barn53/barn53-kicad-library/projects/jlcpcb/readme.md

# JLCPCB KiCAD project

This is to store presets especially for PCBNew to match JLCPCB requirements.
