barn53/barn53-kicad-library/3dmodels/JUSHUO_AFC07-S40FCC-00.obj

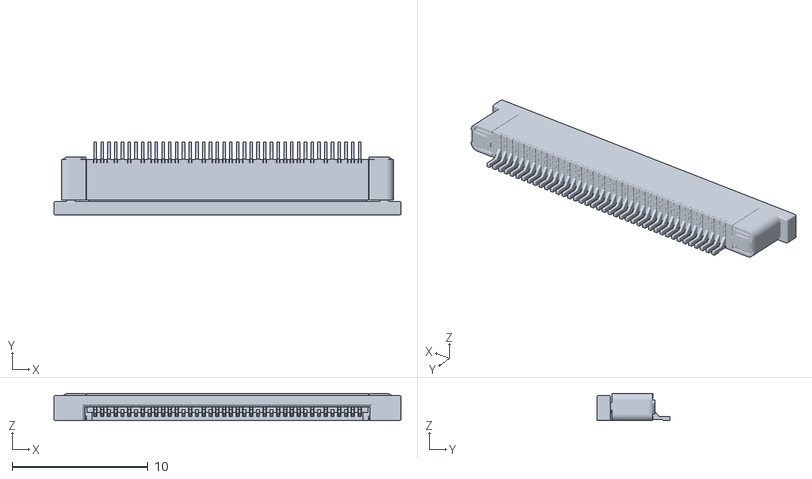
[picture p1: CAD file, 2022-10-30]
3dmodels/JUSHUO_AFC07-S40FCC-00.obj
25.6 x 5.40 x 2.00
