barn53/barn53-kicad-library/3dmodels/JUSHUO_AFC07-S40ECC-00.obj

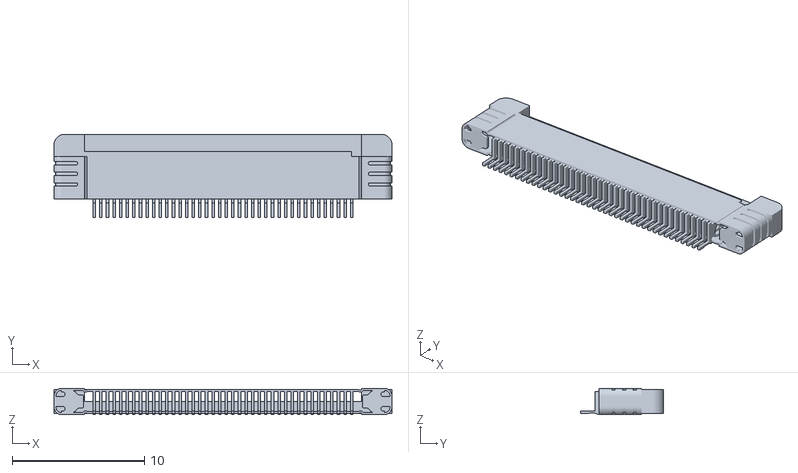
[picture p2: CAD file, 2022-10-30]
3dmodels/JUSHUO_AFC07-S40ECC-00.obj
25.6 x 6.32 x 2.00
