barn53/barn53-kicad-library/3dmodels/JUSHUO_AFC11-S40ICC-00.obj

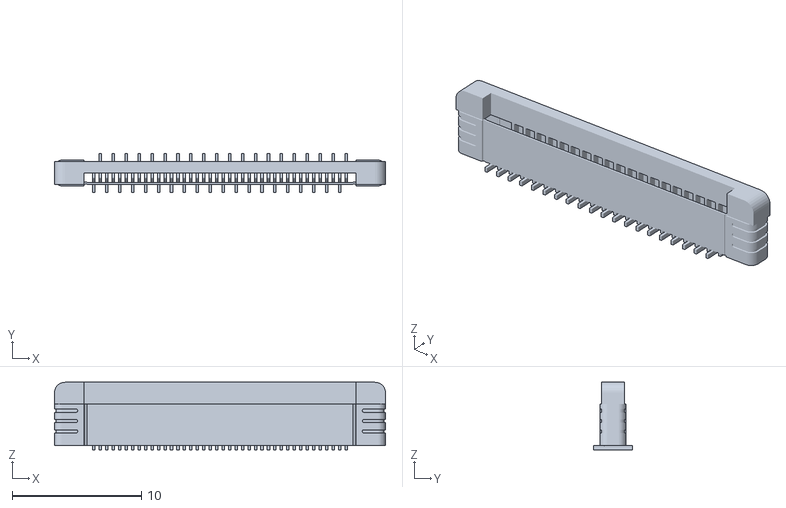
[picture p3: CAD file, 2022-10-30]
3dmodels/JUSHUO_AFC11-S40ICC-00.obj
25.6 x 3.00 x 5.22
