barn53/barn53-kicad-library/3dmodels/IPS_Display_240x320_FPC_105deg.step

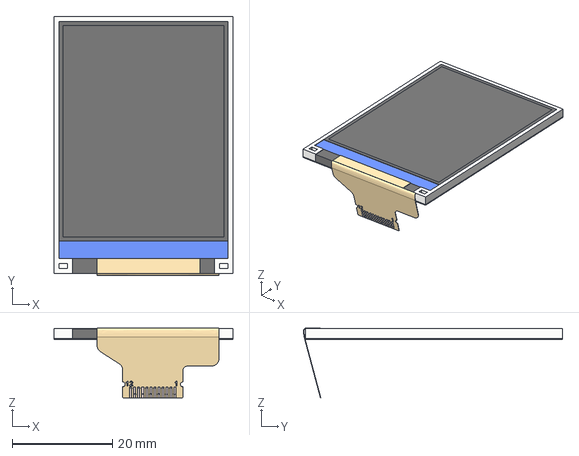
[picture p4: CAD file, 2021-10-30]
3dmodels/IPS_Display_240x320_FPC_105deg.step
35.7 x 51.7 x 14.0 mm
Display
FPC 105
