barn53/barn53-kicad-library/3dmodels/nch8200hv_v2.1.0.1.step

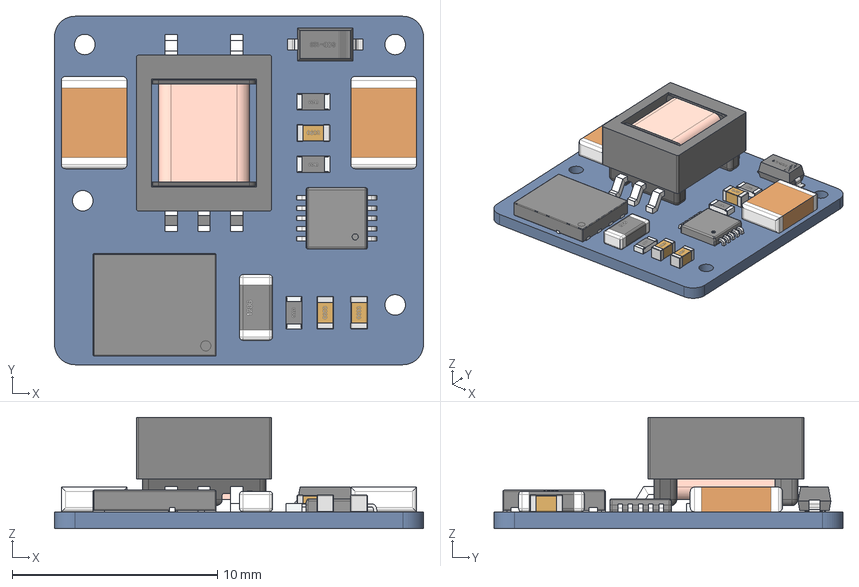
[picture p5: CAD file, 2021-10-26]
3dmodels/nch8200hv_v2.1.0.1.step
18.0 x 17.0 x 5.42 mm
Board
SW3dPS-uMAX10_Part_141
SW3dPS-uMAX10_Part_2291
SW3dPS-uMAX10_Part_1911
SW3dPS-uMAX10_Part_1987
SW3dPS-uMAX10_Part_1492
SW3dPS-uMAX10_Part_2139
SW3dPS-uMAX10_Part_2443
SW3dPS-uMAX10_Part_1799
SW3dPS-uMAX10_Part_2367
SW3dPS-uMAX10_Part_2215
SW3dPS-uMAX10_Part_2063
TTRN-060S
R_0603 x 3
LOGO? x 6
1206R2
User_Library-SON8-5x6mm
SOD-123
LOGOﾔｲ｣ｭ｣ｰ.｣ｳ
1812C x 2
C_0603 x 3
