barn53/barn53-kicad-library/3dmodels/NIXIE Tube Z5900M.step

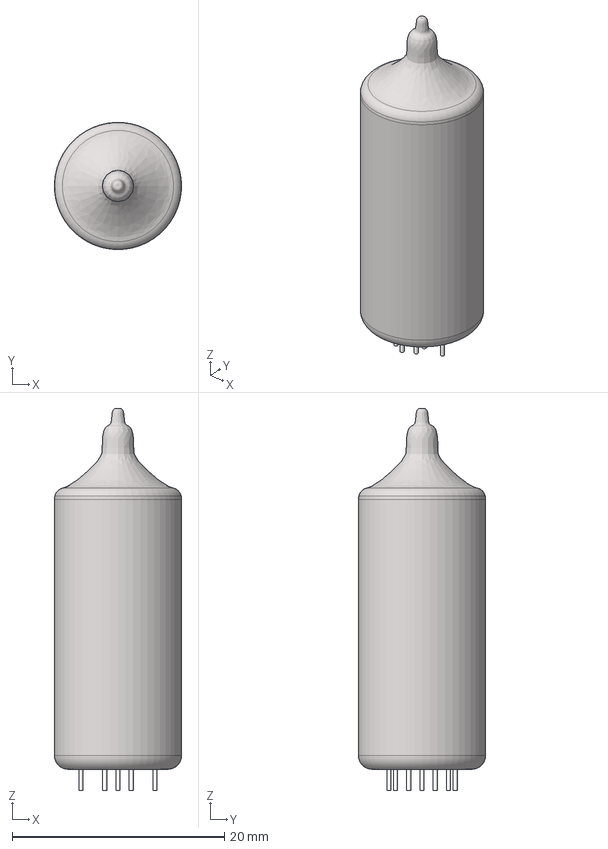
[picture p6: CAD file, 2021-10-26]
3dmodels/NIXIE Tube Z5900M.step
12.0 x 12.0 x 36.0 mm
