barn53/barn53-kicad-library/3dmodels/IPS_Display_240x320_FPC_180deg.step

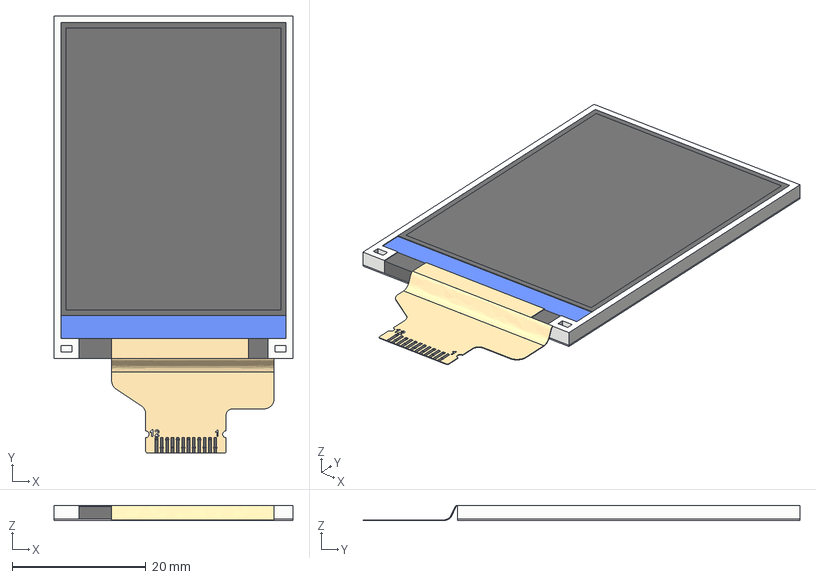
[picture p7: CAD file, 2021-10-25]
3dmodels/IPS_Display_240x320_FPC_180deg.step
35.7 x 65.3 x 2.30 mm
Display
FPC straight
