barn53/barn53-kicad-library/3dmodels/IPS_Display_240x320_FPC_360deg.step

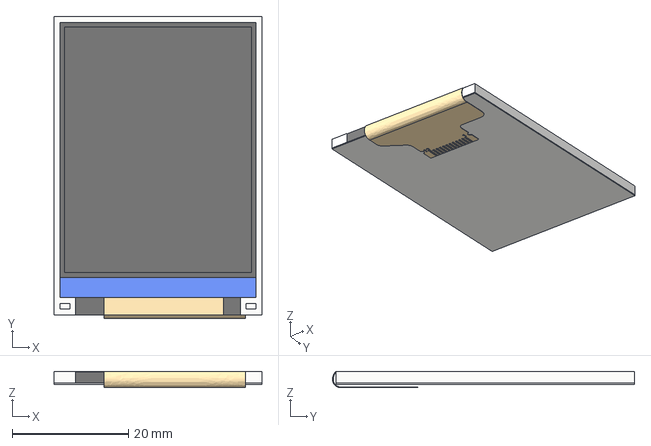
[picture p8: CAD file, 2021-10-25]
3dmodels/IPS_Display_240x320_FPC_360deg.step
35.7 x 51.9 x 2.82 mm
Display
FPC below
