barn53/barn53-kicad-library/3dmodels/NIXIE Tube IN12-B.step

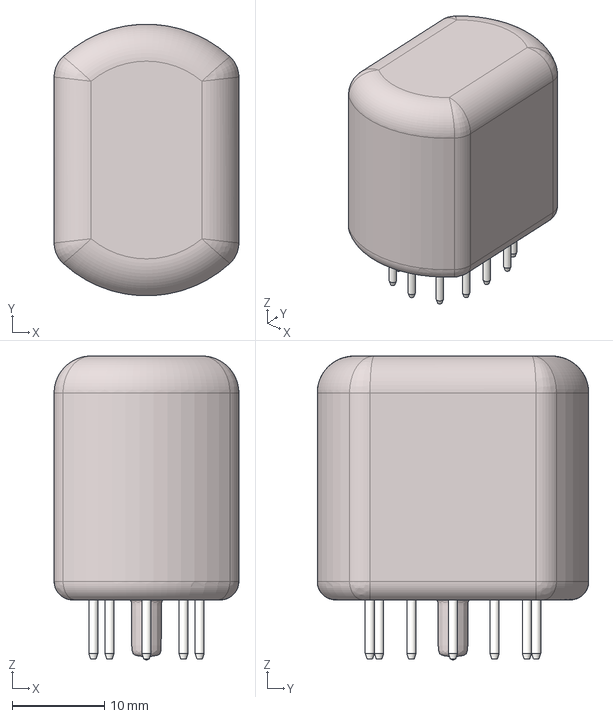
[picture p9: CAD file, 2021-07-06]
3dmodels/NIXIE Tube IN12-B.step
20.0 x 29.4 x 32.9 mm
