barn53/barn53-kicad-library/3dmodels/ePaper_4,2_inch_FPC_180deg.step

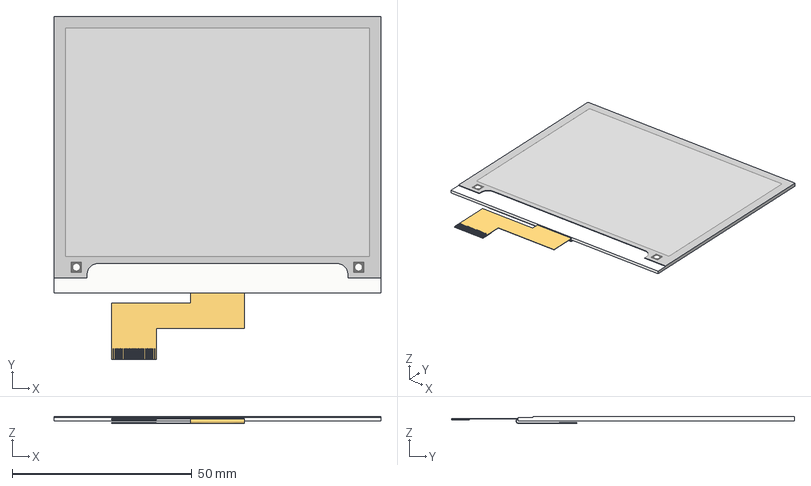
[picture p10: CAD file, 2021-05-12]
3dmodels/ePaper_4,2_inch_FPC_180deg.step
91.0 x 95.5 x 1.87 mm
