barn53/barn53-kicad-library/3dmodels/FPC 24 - AFC07-S24ECA-00.step

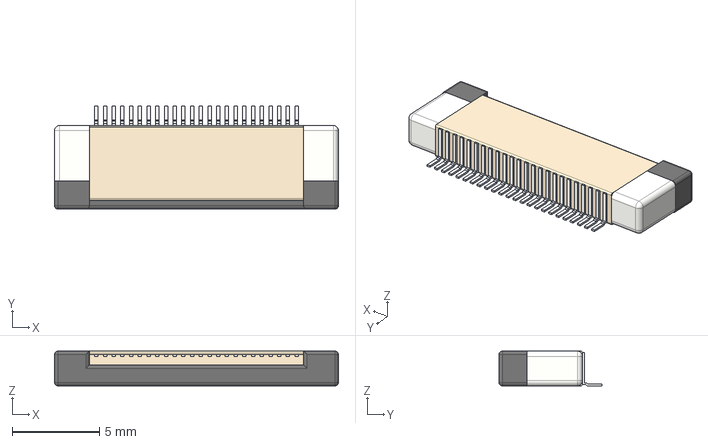
[picture p11: CAD file, 2021-04-11]
3dmodels/FPC 24 - AFC07-S24ECA-00.step
16.3 x 5.92 x 2.00 mm
