barn53/barn53-kicad-library/3dmodels/IPS_Display_240x240_FPC_80deg.step

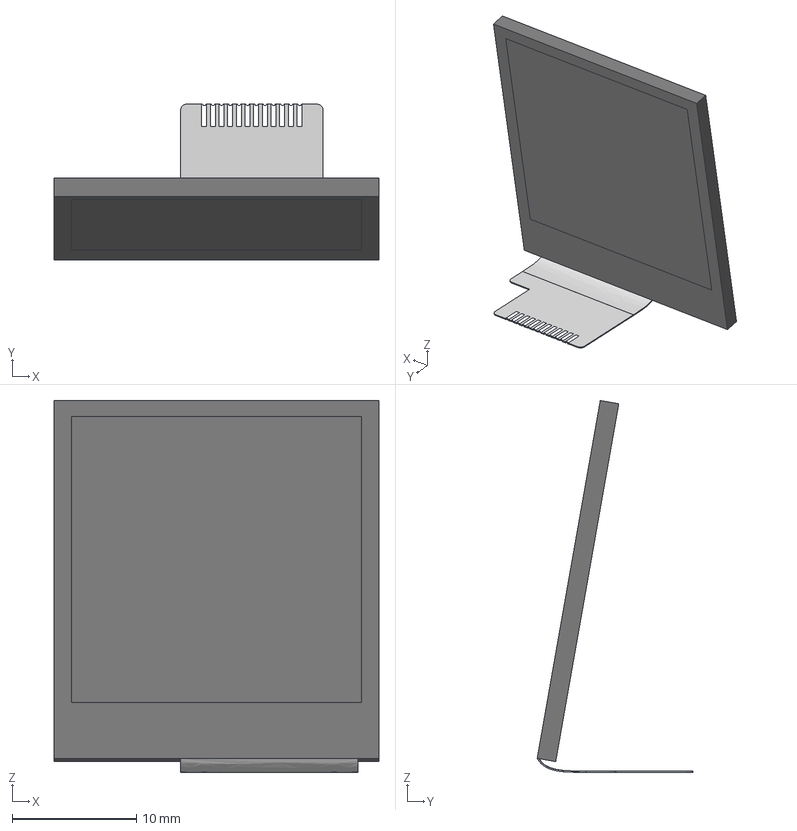
[picture p12: CAD file, 2021-01-22]
3dmodels/IPS_Display_240x240_FPC_80deg.step
26.2 x 12.6 x 30.0 mm
