barn53/barn53-kicad-library/3dmodels/WS2812B-2020.step

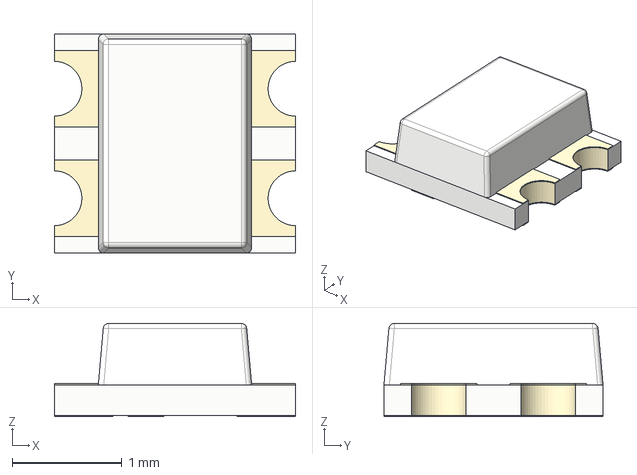
[picture p13: CAD file, 2021-01-22]
3dmodels/WS2812B-2020.step
2.20 x 2.00 x 0.85 mm
