barn53/barn53-kicad-library/3dmodels/IPS_Display_240x240_FPC_15deg.step

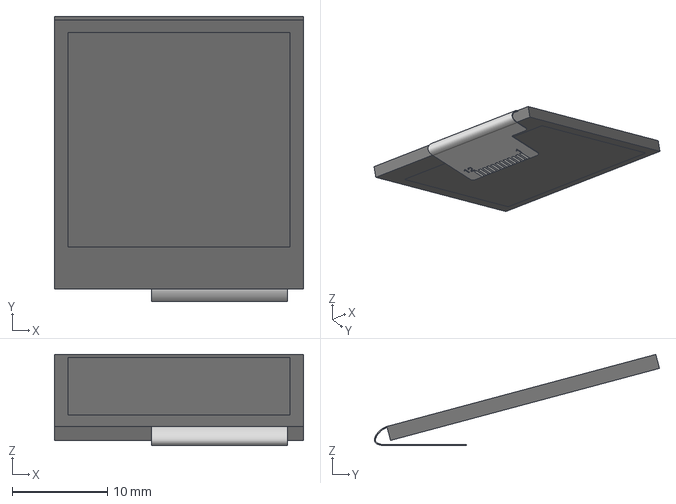
[picture p14: CAD file, 2021-01-07]
3dmodels/IPS_Display_240x240_FPC_15deg.step
26.2 x 30.0 x 9.59 mm
