barn53/barn53-kicad-library/3dmodels/IPS Display 80x160 bottom.step

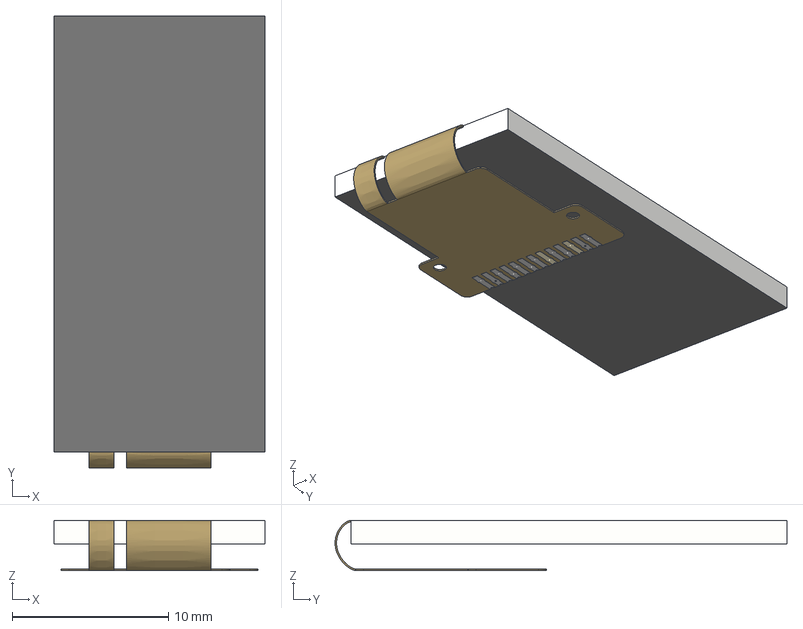
[picture p15: CAD file, 2021-01-07]
3dmodels/IPS Display 80x160 bottom.step
13.5 x 28.9 x 3.21 mm
