barn53/barn53-kicad-library/3dmodels/IPS Display 80x160 top.step

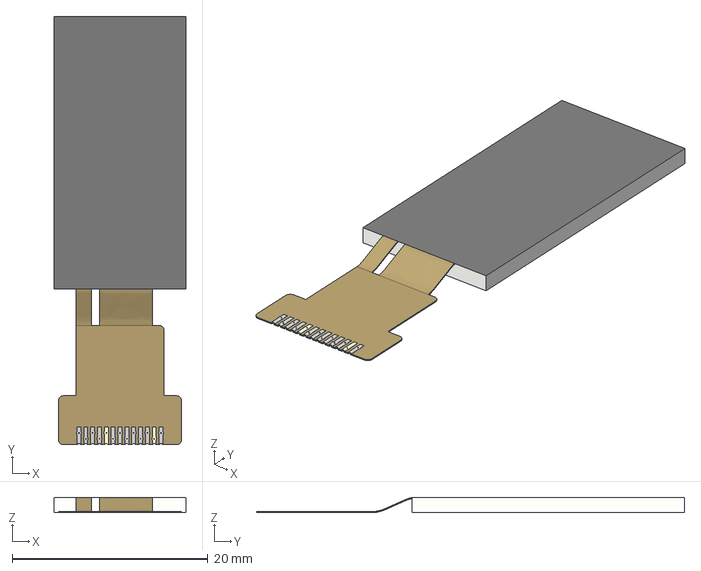
[picture p16: CAD file, 2021-01-07]
3dmodels/IPS Display 80x160 top.step
13.5 x 43.8 x 1.50 mm
