barn53/barn53-kicad-library/3dmodels/SMD Push Button vertical.step

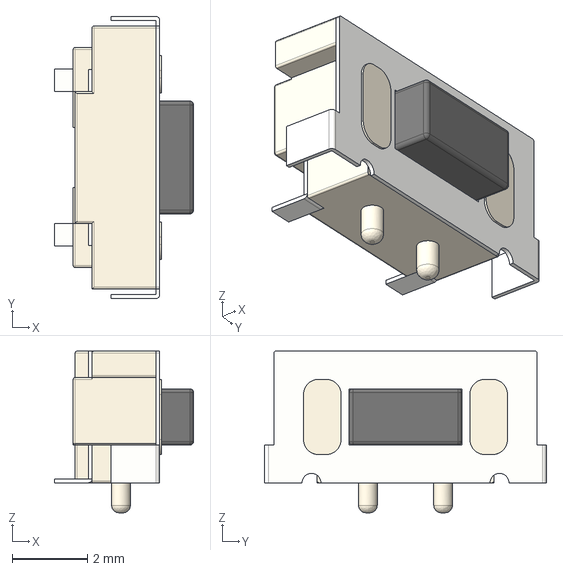
[picture p17: CAD file, 2020-10-26]
3dmodels/SMD Push Button vertical.step
3.70 x 7.50 x 4.30 mm
