barn53/barn53-kicad-library/3dmodels/PogoPin 50x650mil.step

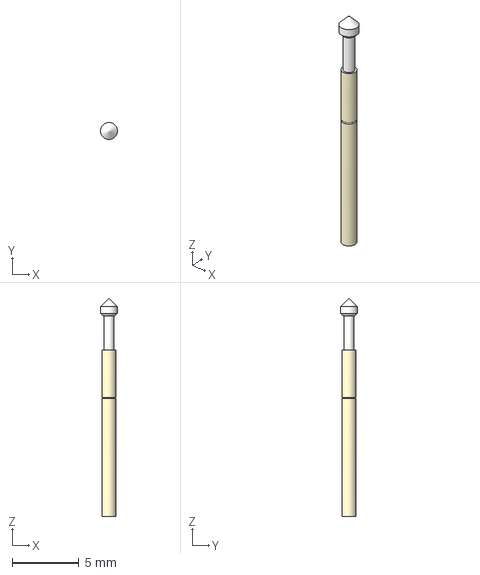
[picture p18: CAD file, 2020-10-06]
3dmodels/PogoPin 50x650mil.step
1.27 x 1.27 x 16.4 mm
