barn53/barn53-kicad-library/3dmodels/SMD Push Button v8.step

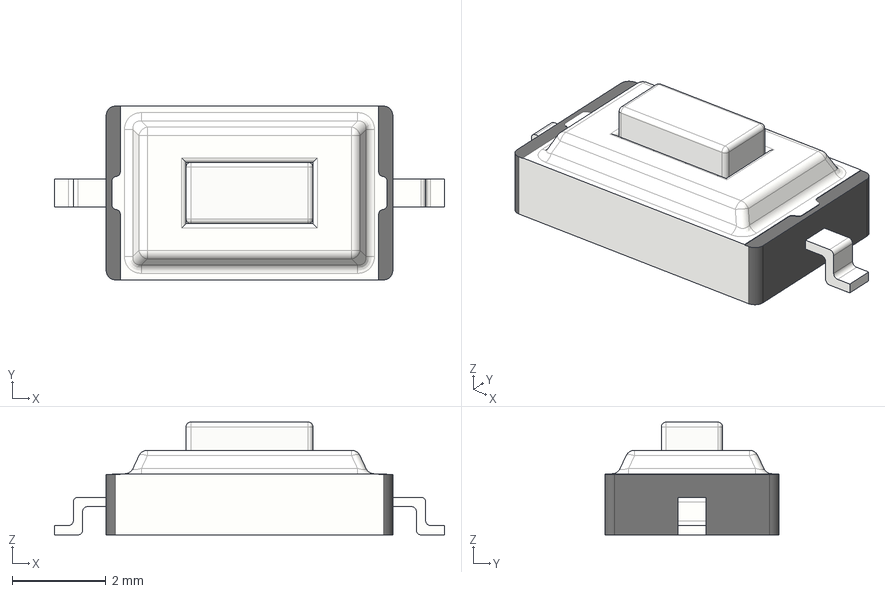
[picture p19: CAD file, 2020-01-07]
3dmodels/SMD Push Button v8.step
8.30 x 3.70 x 2.40 mm
