barn53/barn53-kicad-library/3dmodels/ADXL345_LGA-14_3x5mm.step

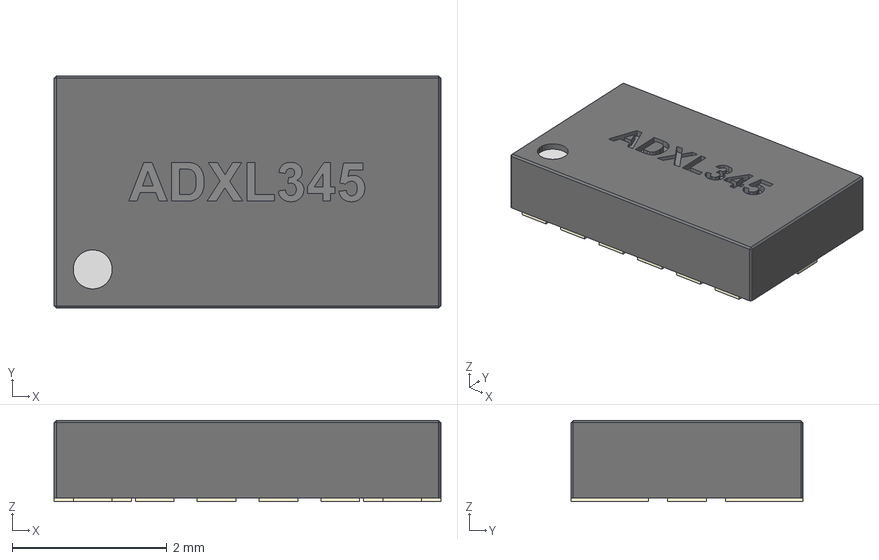
[picture p20: CAD file, 2019-11-14]
3dmodels/ADXL345_LGA-14_3x5mm.step
5.00 x 3.00 x 1.05 mm
