barn53/barn53-kicad-library/3dmodels/PowerPAK SC70-6L.step

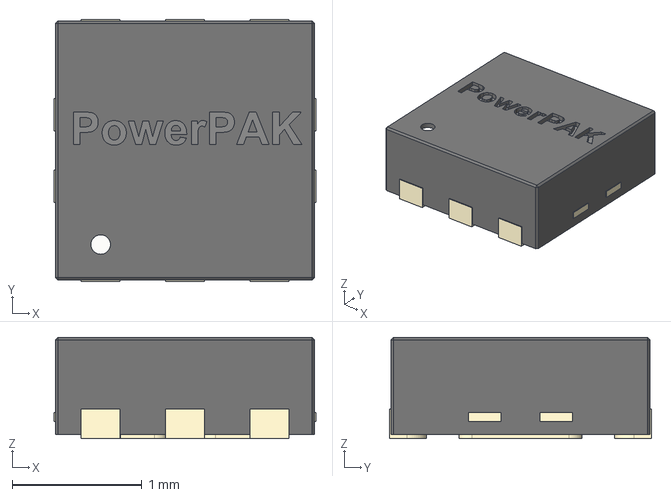
[picture p21: CAD file, 2019-11-14]
3dmodels/PowerPAK SC70-6L.step
2.02 x 2.02 x 0.78 mm
