barn53/barn53-kicad-library/3dmodels/WS2812D-F8.step

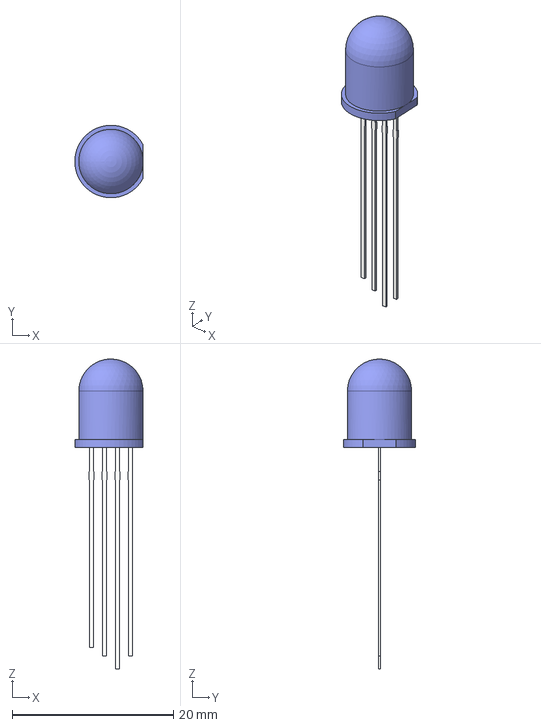
[picture p22: CAD file, 2019-11-13]
3dmodels/WS2812D-F8.step
8.49 x 9.00 x 38.5 mm
