barn53/barn53-kicad-library/3dmodels/WS2812D-F5.step

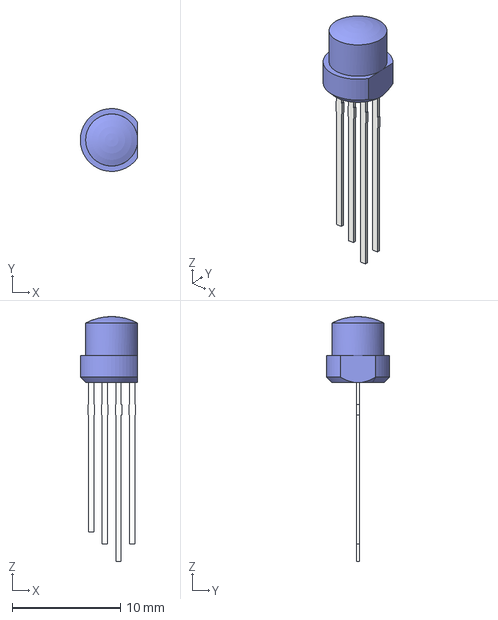
[picture p23: CAD file, 2019-11-13]
3dmodels/WS2812D-F5.step
5.29 x 5.80 x 22.6 mm
