barn53/barn53-kicad-library/3dmodels/DFPlayer Mini Assem v1.step

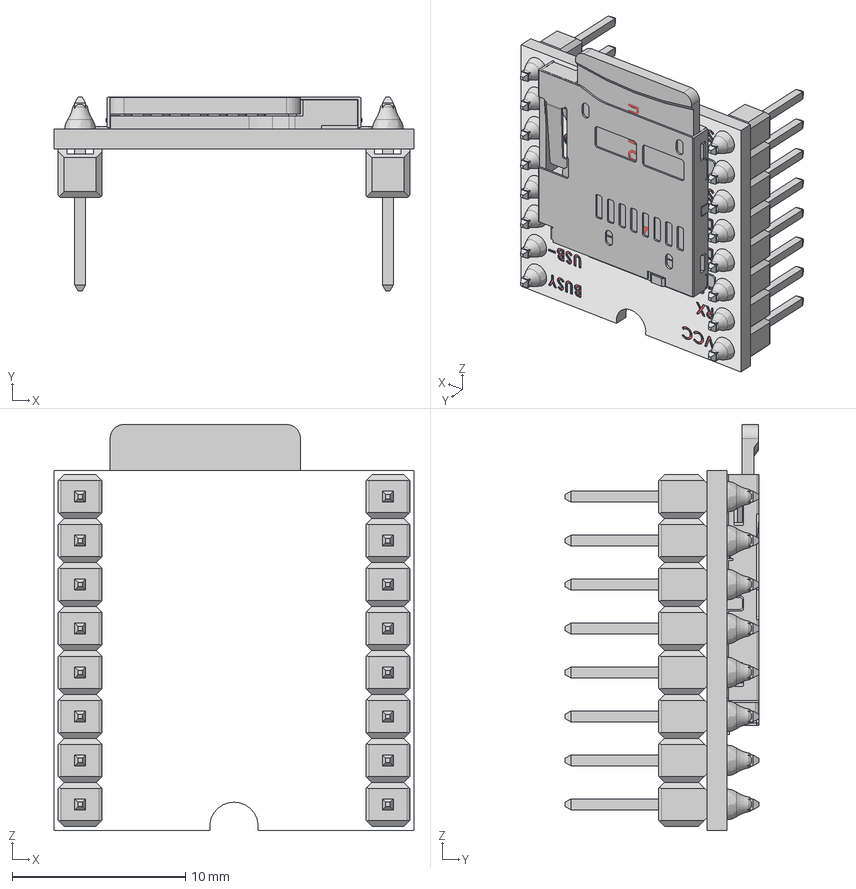
[picture p24: CAD file, 2019-11-03]
3dmodels/DFPlayer Mini Assem v1.step
20.8 x 11.2 x 23.5 mm
DFPlayer Mini PCB
CD card slot
Micro sd card
11_20mm pin x 16
Pin Header 1x12 TH Pitch 2 x 16
solder x 16
