barn53/barn53-kicad-library/3dmodels/RCWL-0516 v10.step

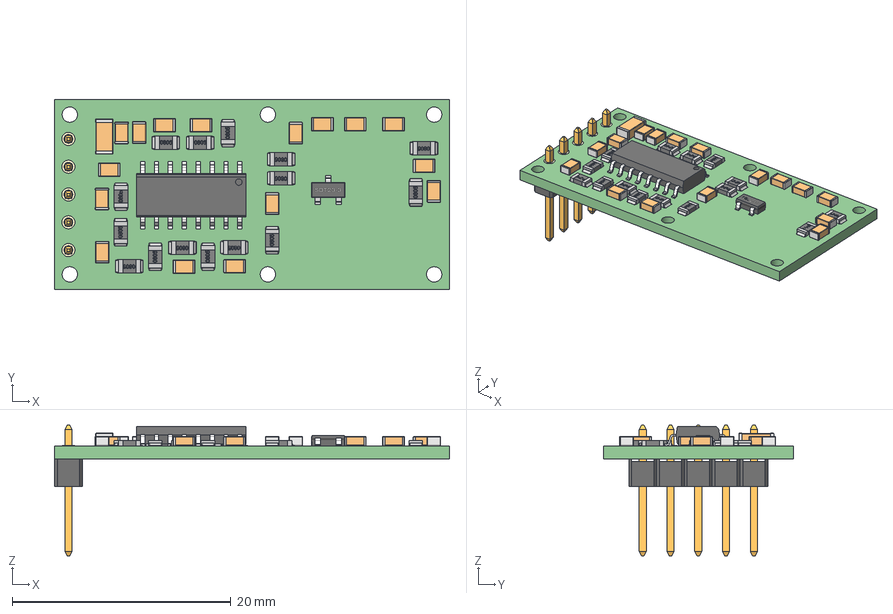
[picture p25: CAD file, 2019-11-03]
3dmodels/RCWL-0516 v10.step
36.1 x 17.4 x 11.9 mm
so16-1 v1
Resistor 0805 x 15
sot23-3_p0-95_l3-04_w1-4
5 pin header
