barn53/barn53-kicad-library/(list of files, cad)

Other CAD files:
3dmodels/10118194c.stp
3dmodels/629105136821.stp
