barn53/barn53-kicad-library/(commit log)

2019-11-04 Use only one KiCad path:
2019-11-04 moved footprints to ./footprints/
2019-11-13 added ws2812 through hole, adxl345
    [ADXL345_LGA-14_3x5mm.step, WS2812D-F5.step, WS2812D-F8.step]
2019-11-14 added package PowerPAK SC70-6L
    [PowerPAK SC70-6L.step]
2019-11-14 beautified adxl345 3d model
    [ADXL345_LGA-14_3x5mm.step]
2019-12-03 Added Footprints for 2.4GHz PCB Antennas
2019-12-09 added MicroUSB_through_hole_fixing
    Modified PCB antennas to makethem usable in PCB design
    [10118194c.stp]
2020-01-07 spring clean
2020-01-07 updated library
    Added QR Code on Silkk Screen for https://barn533.de
    Added small Solder Jumper
    Added own Push Button Footprint
    [SMD Push Button v8.step]
2020-09-02 new items
    [10118194c.stp, 629105136821.stp, ADXL345_LGA-14_3x5mm.step, DFPlayer Mini Assem v1.step, PowerPAK SC70-6L.step, RCWL-0516 v10.step, SMD Push Button v8.step, WS2812D-F5.step]
2020-10-06 New: PogoPin 50x650mil
    horizontal and vertical
    [PogoPin 50x650mil.step]
2020-10-26 new stuff
    [SMD Push Button vertical.step, jlcpcb.kicad_pcb, jlcpcb.sch]
2021-01-06 Added IPS 240x240 Display Part and Footprint
    [IPS_Display_240x240_FPC_15.step, jlcpcb.kicad_pcb]
2021-01-07 IPS Display 80x160
    [IPS Display 80x160 bottom.step, IPS Display 80x160 top.step]
2021-01-07 changed preset values
    [jlcpcb.kicad_pcb]
2021-01-15 added 4 layer jlcpcb template
    [jlcpcb4layer.kicad_pcb, jlcpcb4layer.sch]
2021-01-18 Display 240x240 with 80° orientation
    [IPS_Display_240x240_FPC_15deg.step, IPS_Display_240x240_FPC_80deg.step]
2021-01-22 fixed display, added ws2812b-2020
    [IPS_Display_240x240_FPC_80deg.step, WS2812B-2020.step]
2021-02-05 fix new footprints
2021-04-11 New FPC 24 footprint
    and minor quirks
    [FPC 24 - AFC07-S24ECA-00.step]
2021-05-12 Added potential second LCSC part number for micro usb connector
2021-07-04 Symbol for IN12-B NIXIE tube
2021-07-06 Added NIXIE tube IN12-B
    [NIXIE Tube IN12-B.step]
2021-07-06 IN12-B two pin versions (1.2 / 1.7mm)
2021-10-25 Added display 240x320
    [IPS_Display_240x320_FPC_180deg.step, IPS_Display_240x320_FPC_360deg.step]
2021-10-26 added nixie stuff
    [NIXIE Tube Z5900M.step, nch8200hv_v2.1.0.1.step]
2021-10-30 esp32 wroom
